CBindahouse/AquaFi/README.md

# UOWC
Underwater Optical Wireless Communications

This is an overview and probably some code to help develop an UOWC system at KAUST, Saudi Arabia.
