CBindahouse/AquaFi/topologies/acronyms.tex

\section{List of Acronyms}
\begin{acronym}
\acro{AGC}{Automatic Gain Control}
\acro{APD}{Avalanche Photodiode}
\acro{BER}{Bit Error Rate}
\acro{FEC}{Forward Error Correction}
\acro{FOV}{Field Of View}
\acro{IM/DD}{Intensity Modulation / Direct Detection}
\acro{ISI}{Inter-Symbol Interference}
\acro{I2C}{Inter-Integrated Circuit}
\acro{KAUST}{King Abdullah University of Science and Technology}
\acro{LDPC}{Low Density Parity Code}
\acro{LED}{Light Emitting Diode}
\acro{LOS}{Line Of Sight}
\acro{MAC}{Medium Access Controller}
\acro{NLOS}{Non Line Of Sight}
\acro{OFDM}{Orthogonal Frequency Division Multiplexing}
\acro{OOK}{On-Off Keying}
\acro{PCIe}{Peripheral Component Interconnect Express}
\acro{PIN}{P-I-N}
\acro{PMT}{Photo Multiplier Tube}
\acro{PPM}{Pulse Position Modulation}
\acro{PWM}{Pulse Width Modulation}
\acro{P2P}{Peer to Peer}
\acro{RF}{Radio Frequency}
\acro{ROV}{Remotely Operated Vehicle}
\acro{RS}{Reed-Solomon}
\acro{RSSI}{Received Signal Strength Indicator}
\acro{SFP}{Small form-factor pluggable}
\acro{SNR}{Signal to Noise Ratio}
\acro{SPAD}{Single Photo Avalanche Diode}
\acro{SPI}{Serial Peripheral Interface}
\acro{UART}{Universal asynchronous receiver/transmitter}
\acro{UOWC}{Underwater Optical Wireless Communication}
\acro{UOWN}{Underwater Optical Wireless Network}
\acro{USB}{Universal Serial Bus}
\end{acronym}
