CBindahouse/AquaFi/topologies/topologies.tex

\documentclass{article}
\usepackage[colorlinks]{hyperref}
\usepackage[printonlyused,withpage]{acronym}
\usepackage{float}
\usepackage{natbib}
\usepackage{graphicx}
\usepackage{todonotes}
\author{Christopher Bainbridge}
\title{Underwater Optical Wireless Network Topologies}

\begin{document}
\maketitle

\begin{abstract}
This document introduces the concept of underwater optical wireless
network topologies, discusses their advantages, disadvantages, as well
as potential data rates and ranges.
\end{abstract}

\include{introduction}
\include{basic_wireless_network_topologies}
\include{applications}
\include{centralized_de-centralized}
\include{available_wireless_communication_technologies}
\include{underwater_sensor_networks}
\include{topology_proposals}

\include{conclusion}

\include{acronyms}

\bibliographystyle{plain}
\bibliography{research}

\end{document}\grid
