CBindahouse/AquaFi/AquaFi-Laser/servo_motor.txt

rb-lyn-74 lynxmotion pan and tilt
hs-m7990th hitec monster torque
