CBindahouse/AquaFi/AquaFi-Laser/development.tex

\documentclass{article}
\usepackage[colorlinks]{hyperref}
\usepackage[printonlyused,withpage]{acronym}
\usepackage{float}
\usepackage{natbib}
\usepackage{graphicx}
\usepackage{todonotes}

\usepackage{listings}
\usepackage{color}

\definecolor{dkgreen}{rgb}{0,0.6,0}
\definecolor{gray}{rgb}{0.5,0.5,0.5}
\definecolor{mauve}{rgb}{0.58,0,0.82}

\lstset{frame=tb,
  language=C,
  aboveskip=3mm,
  belowskip=3mm,
  showstringspaces=false,
  columns=flexible,
  basicstyle={\small\ttfamily},
  numbers=none,
  numberstyle=\tiny\color{gray},
  keywordstyle=\color{blue},
  commentstyle=\color{dkgreen},
  stringstyle=\color{mauve},
  breaklines=true,
  breakatwhitespace=true,
  tabsize=3
}

\author{Christopher Bainbridge}
\title{Underwater Optical Wireless Communications - Development}

\begin{document}
\maketitle

\begin{abstract}
This document serves as a document of the development for an \ac{UOWC} system
that has happened at \ac{KAUST}.
\end{abstract}

\include{notes}

\include{acronyms}

\bibliographystyle{plain}
\bibliography{research}

\end{document}\grid
