CBindahouse/AquaFi/general_background/general_background_uowc.tex

\documentclass{article}
\usepackage[colorlinks]{hyperref}
\usepackage[printonlyused,withpage]{acronym}
\usepackage{float}
\usepackage{natbib}
\usepackage{graphicx}
\usepackage{todonotes}
\author{Christopher Bainbridge}
\title{Underwater Optical Wireless Communications - A Background}

\begin{document}
\maketitle

\begin{abstract}
This document serves as a background and brief summary of \ac{UOWC}. It
describes information required for the project, a description of current
systems (both research and commercial) as well as the developed system at
\ac{KAUST}. It then proceeds to suggest solutions to overcome current
issues.
\end{abstract}

\include{introduction}
\include{background}
\include{system_design}
\include{research_systems}
\include{current_systems}
\include{system_aims}
\include{system_specification}

\section{Conclusions}
This document has summarized a general background behind \ac{UOWC}, the current
implementations and drawbacks, and improvements that can be made to the system.

\include{acronyms}

\bibliographystyle{plain}
\bibliography{research}

\end{document}\grid
