CBindahouse/AquaFi/AquaFi-Laser/IMG_20190701_1606117.pdf

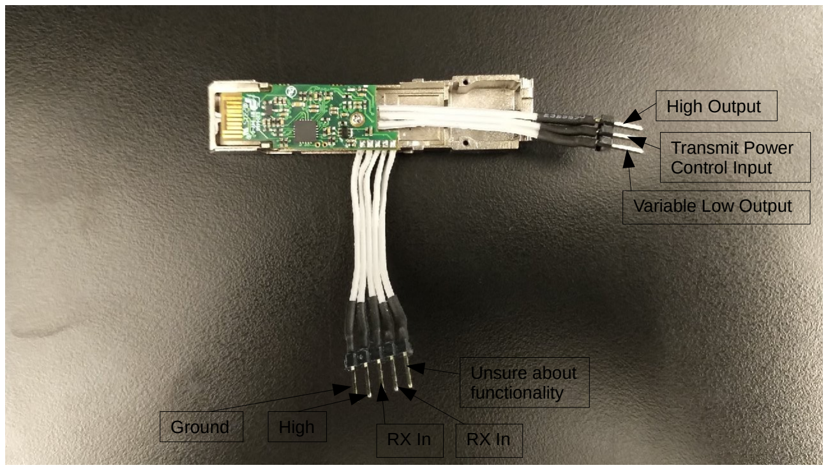
[picture p12: page 1]

High Output

Variable Low Output

Transmit Power
Control Input
Ground | High
RX In | RX In

Unsure about
functionality
