CBindahouse/AquaFi/AquaFi-Laser/IMG_20190701_1606117.jpg

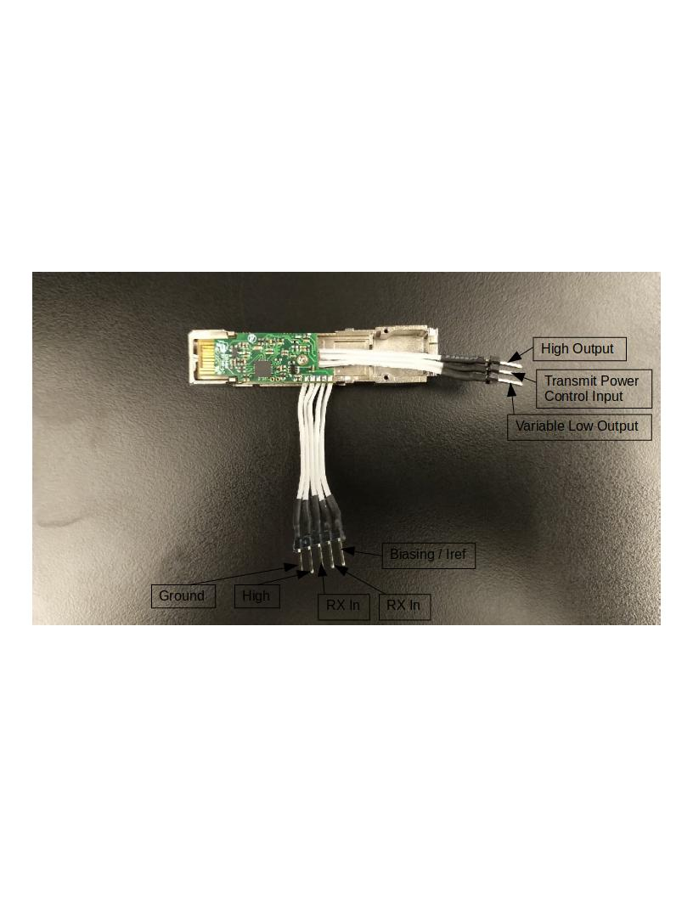
AquaFi-Laser/IMG_20190701_1606117.jpg
