CBindahouse/AquaFi/AquaFi-Laser/IMG_20190703_1703286.jpg

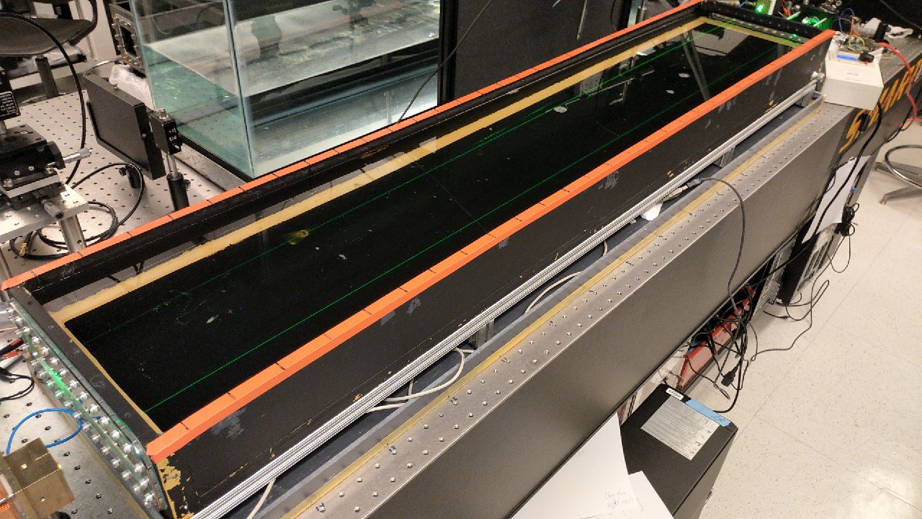
AquaFi-Laser/IMG_20190703_1703286.jpg
