CBindahouse/AquaFi/AquaFi-Laser/Nichia 1-W-green and 3.5-W-blue laser diodes.jpg

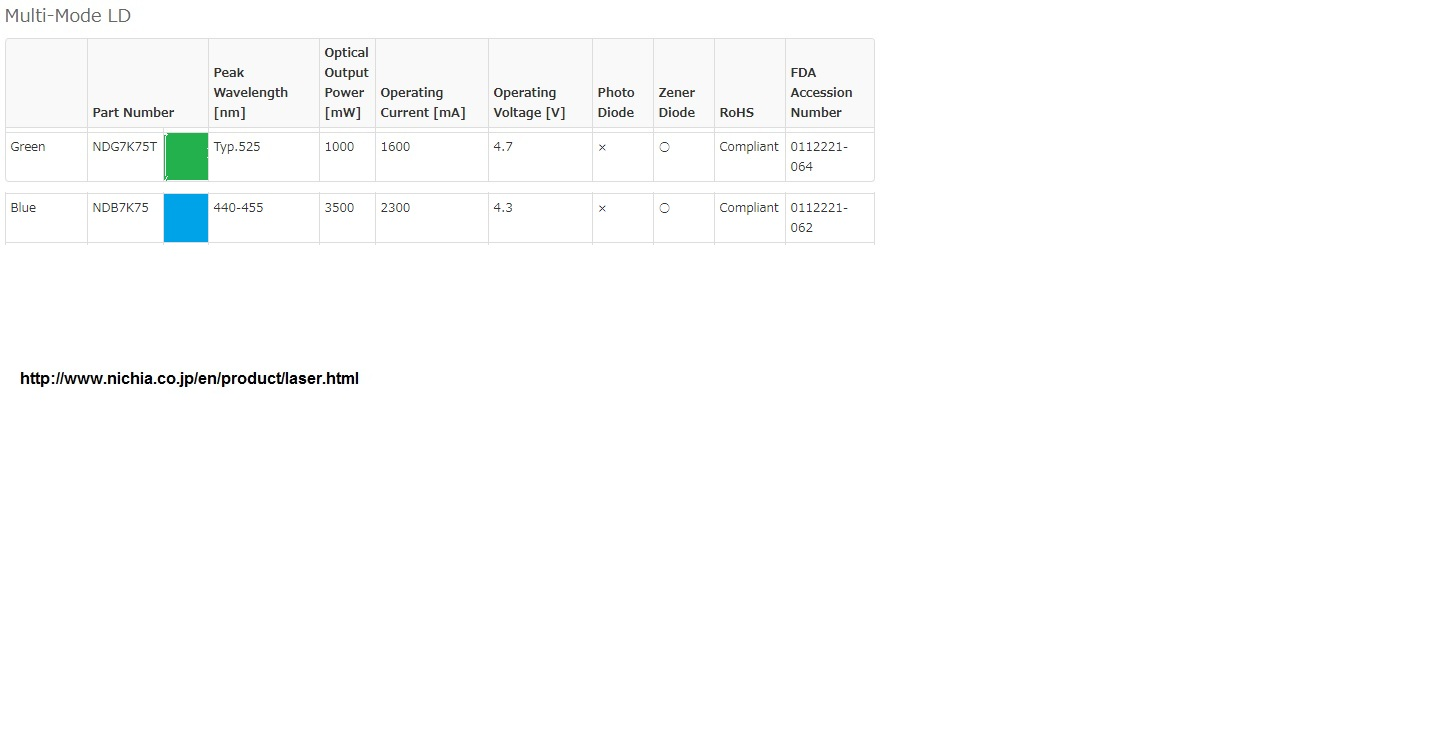
AquaFi-Laser/Nichia 1-W-green and 3.5-W-blue laser diodes.jpg
