CBindahouse/AquaFi/AquaFi-LED/aqua-fi-system.png

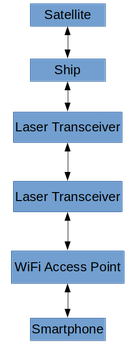
AquaFi-LED/aqua-fi-system.png
