CBindahouse/AquaFi/AquaFi-LED/receiver.png

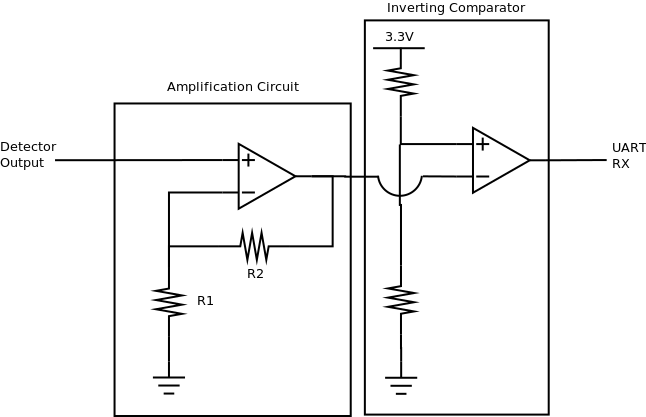
AquaFi-LED/receiver.png
