CBindahouse/AquaFi/AquaFi-Laser/tx_circuit.asc

D1: LED; LXK2-PW14
Q1: npn; 2SCR293P
R1: res; 100
R2: res; 100
R3: res; 200
R4: res; 100
R5: res; 5
U1: AD8099
U2: AD8099
V1: voltage; 3.3
V2: voltage; PULSE(0 3.3 0.1 0.01 0.01 0.01 0 50)
V3: voltage; 7
Named nets: 0
.tran 1
