CBindahouse/AquaFi/(commit log)

2019-03-24 Add initial commit for the General Background document
    This covers the introduction, general light propagation, water types,
    configurations of UOWC, current optical systems (both above and below
    water) and a list of acronyms.
2019-03-24 This is all the stuff I was given from the previous PhD student
    Configuration for Raspberry Pi, setup etc.
2019-03-26 Add extra information to General Background
    This adds more info on the following:
    System aims
    Current system setup
    Current limitations
2019-03-27 Add .ods table that was used to generate latex table
    [table_of_research_systems.ods]
2019-03-27 Add a bit more information.
    [table_of_research_systems.ods]
2019-03-28 Add a little more info about current project
2019-03-28 Update more information on current system
2019-03-28 Add Underwater Optical Wireless Communication to bibliography
2019-03-28 Found a good network single board PC with SFP
2019-03-31 Add some stuff in about low power
    Otherwise we'll run out of energy fast!
2019-04-07 Add a bit on Raspberry Pi Wifi update
2019-04-07 I found what was in the EEPROM memory
    Used i2cdump to get the information.
2019-04-08 Add systemctl commands required for setting up Raspberry Pi
2019-04-09 Add information about AGC and current system. Add PDFs.
    These were from TK / Omar.
2019-04-09 Add information about reference designs and a teardown of SFP connector
    I took the SFP connector apart to have a look inside. This is what I found.
2019-05-02 Update notes.tex
    Added some notes about how I've
    been trying to test the SFP connector
    that has been dismantled.
2019-05-09 Add some info on the EEPROM
    This is what was copied out of one of
    the EEPROMs plus some calculations
    in the spreadsheet
    [original_eeprom.ods]
2019-06-23 Added start of Topologies document
    This is a new document that I have been
    asked to start writing, which is about
    underwater wireless network topologies.
2019-07-01 Ensure Makefiles have bib files to track changes on
2019-07-01 Add pinout diagram for SFP connector
2020-06-17 Move OLD to AquaFi-LED and development to AquaFi-Laser
    [original_eeprom.ods]
